felixheld/ewal/README.md

# ewal

The electric water level is a small project which uses a 3-axis accelerometer, a microcontroller (ATTiny48) and 5 LEDs to act as a digital water level.

It is used as a small project to teach people SMD soldering with stencils, solder paste and a soldering oven.
