felixheld/ewal/hw/ewal.brd

## EAGLE design hw/ewal.brd (2014-11-25)

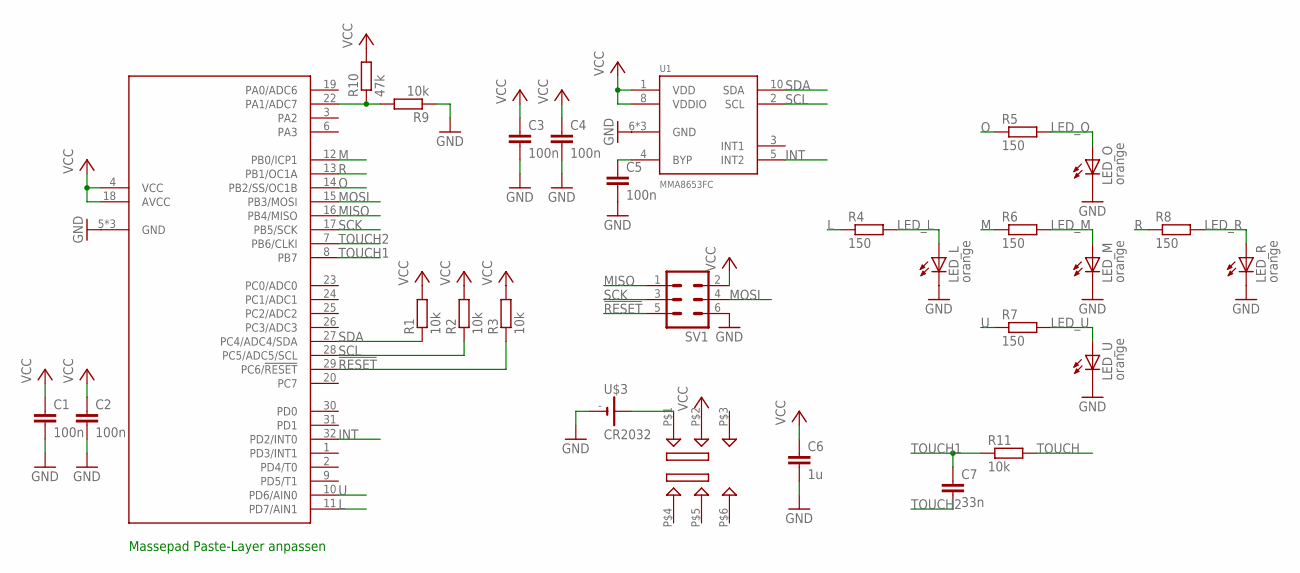
[picture p1: schematic ewal.sch]

Parts:
C1, C2, C3, C4, C5: 100n; C0603
C6: 1u; C0805
C7: 33n; C0603
LED_L: orange; CHIP-LED0603
LED_M: orange; CHIP-LED0603
LED_O: orange; CHIP-LED0603
LED_R: orange; CHIP-LED0603
LED_U: orange; CHIP-LED0603
R1, R2, R3, R9, R11: 10k; R0603
R4, R5, R6, R7, R8: 150; R0603
R10: 47k; R0603
SV1: MA03-2
U1: MMA8653FC; 2X2_DFN_LONGPADS
U2: ATTINY48; MLF32-TH
U$3: CR2032; BK-912
U$4: JS202011SCQN

Connections:
!RESET: R3.1, SV1.5, U2.29 (PC6/!RESET)
GND: C1.2, C2.2, C3.2, C4.2, C5.2, C6.2, LED_L.C, LED_M.C, LED_O.C, LED_R.C, LED_U.C, R9.1, SV1.6, U1.6 (GND), U1.7 (GND), U1.9 (GND), U2.5 (GND), U2.21 (GND), U2.TH (GND), U$3.-
INT: U1.5 (INT2), U2.32 (PD2/INT0)
L: R4.1, U2.11 (PD7/AIN1)
LED_L: LED_L.A, R4.2
LED_M: LED_M.A, R6.2
LED_O: LED_O.A, R5.2
LED_R: LED_R.A, R8.2
LED_U: LED_U.A, R7.2
M: R6.1, U2.12 (PB0/ICP1)
MISO: SV1.1, U2.16 (PB4/MISO)
MOSI: SV1.4, U2.15 (PB3/MOSI)
unnamed: C5.1, U1.4 (BYP)
O: R5.1, U2.14 (PB2/SS/OC1B)
R: R8.1, U2.13 (PB1/OC1A)
SCK: SV1.3, U2.17 (PB5/SCK)
SCL: R2.1, U1.2 (SCL), U2.28 (PC5/ADC5/SCL)
SDA: R1.1, U1.10 (SDA), U2.27 (PC4/ADC4/SDA)
TOUCH: R11.2
TOUCH1: C7.1, R11.1, U2.8 (PB7)
TOUCH2: C7.2, U2.7 (PB6/CLKI)
U: R7.1, U2.10 (PD6/AIN0)
VCC: C1.1, C2.1, C3.1, C4.1, C6.1, R1.2, R2.2, R3.2, R10.2, SV1.2, U1.1 (VDD), U1.8 (VDDIO), U2.4 (VCC), U2.18 (AVCC), U$4.P$2
V_BAT: U$3.+@1 (+), U$3.+@2 (+), U$4.P$1
V_SENSE: R9.2, R10.1, U2.22 (PA1/ADC7)

Notes on the sheet:
Massepad Paste-Layer anpassen

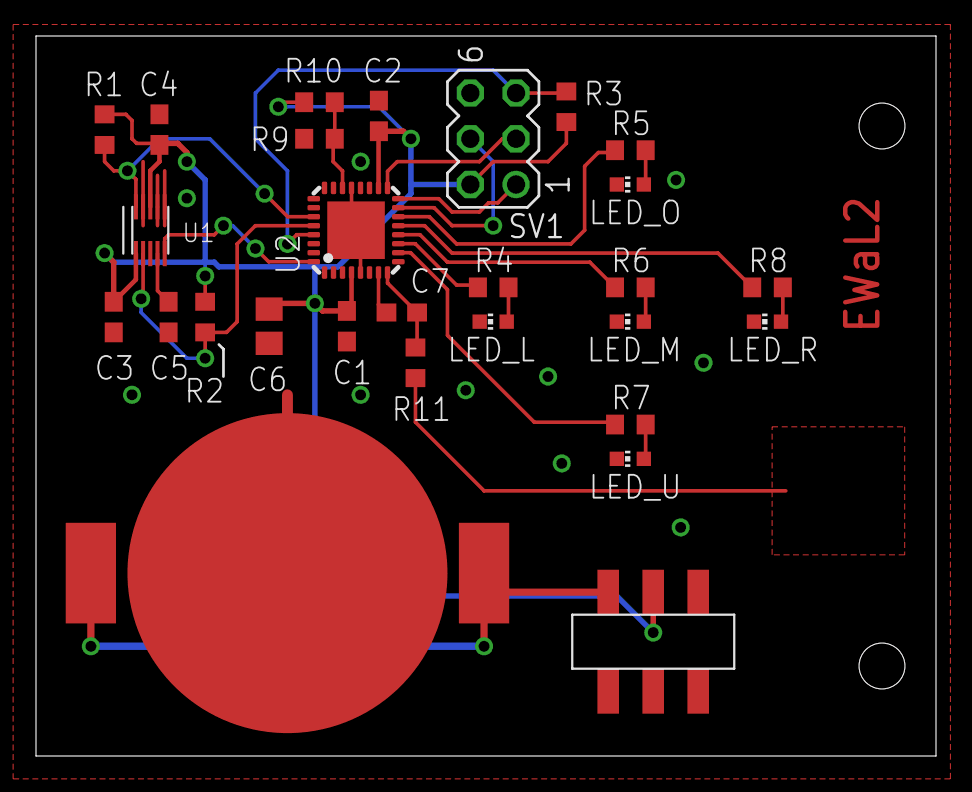
[picture p2: board ewal.brd from above]

Board: 2 copper layers, 50.0 x 40.0 mm, 28 parts (0 on the bottom side), 24 nets.
