felixheld/ewal/(commit log)

2014-01-26 create schematic and layout of hardware
    [ewal.brd, ewal.sch]
2014-04-21 add bill of materials
2014-04-23 remove silkscreen from the accelerometer's pads
    [ewal.brd, ewal.sch]
2014-06-21 initial software release on the GPN14
    the electronic water bubble function is only implemented for one orientation
    Peter Fleury's TWI library is used for i2c communication
2014-11-09 update to version 2
    now with a touch sensor and a different stencil layout for the sensor
    [ewal.brd, ewal.sch]
2014-11-10 update the bill of materials
2014-11-24 Set solder paste reduction to 20%
    [ewal.brd]
2014-11-25 Fixed thermal pad paste aperture, was too big previously
    [ewal.brd, ewal.sch]
2014-11-26 Added filtering and different orientation cases, aswell as a Makefile
2014-11-26 Modified .gitignore to ignore gerber output files
2014-11-27 Fixed minor errors in Wall-mode and filtering
    [main.c]
2014-11-27 Added PWM for LEDs
2014-11-29 Add Calibration defines and a deadzone for the PWM
2014-12-25 add assembling instructions
2014-12-25 move and update assembly instructions
